Kreyl/LocketSound/SndLocket_hw/Pdf/SndLocket.pdf

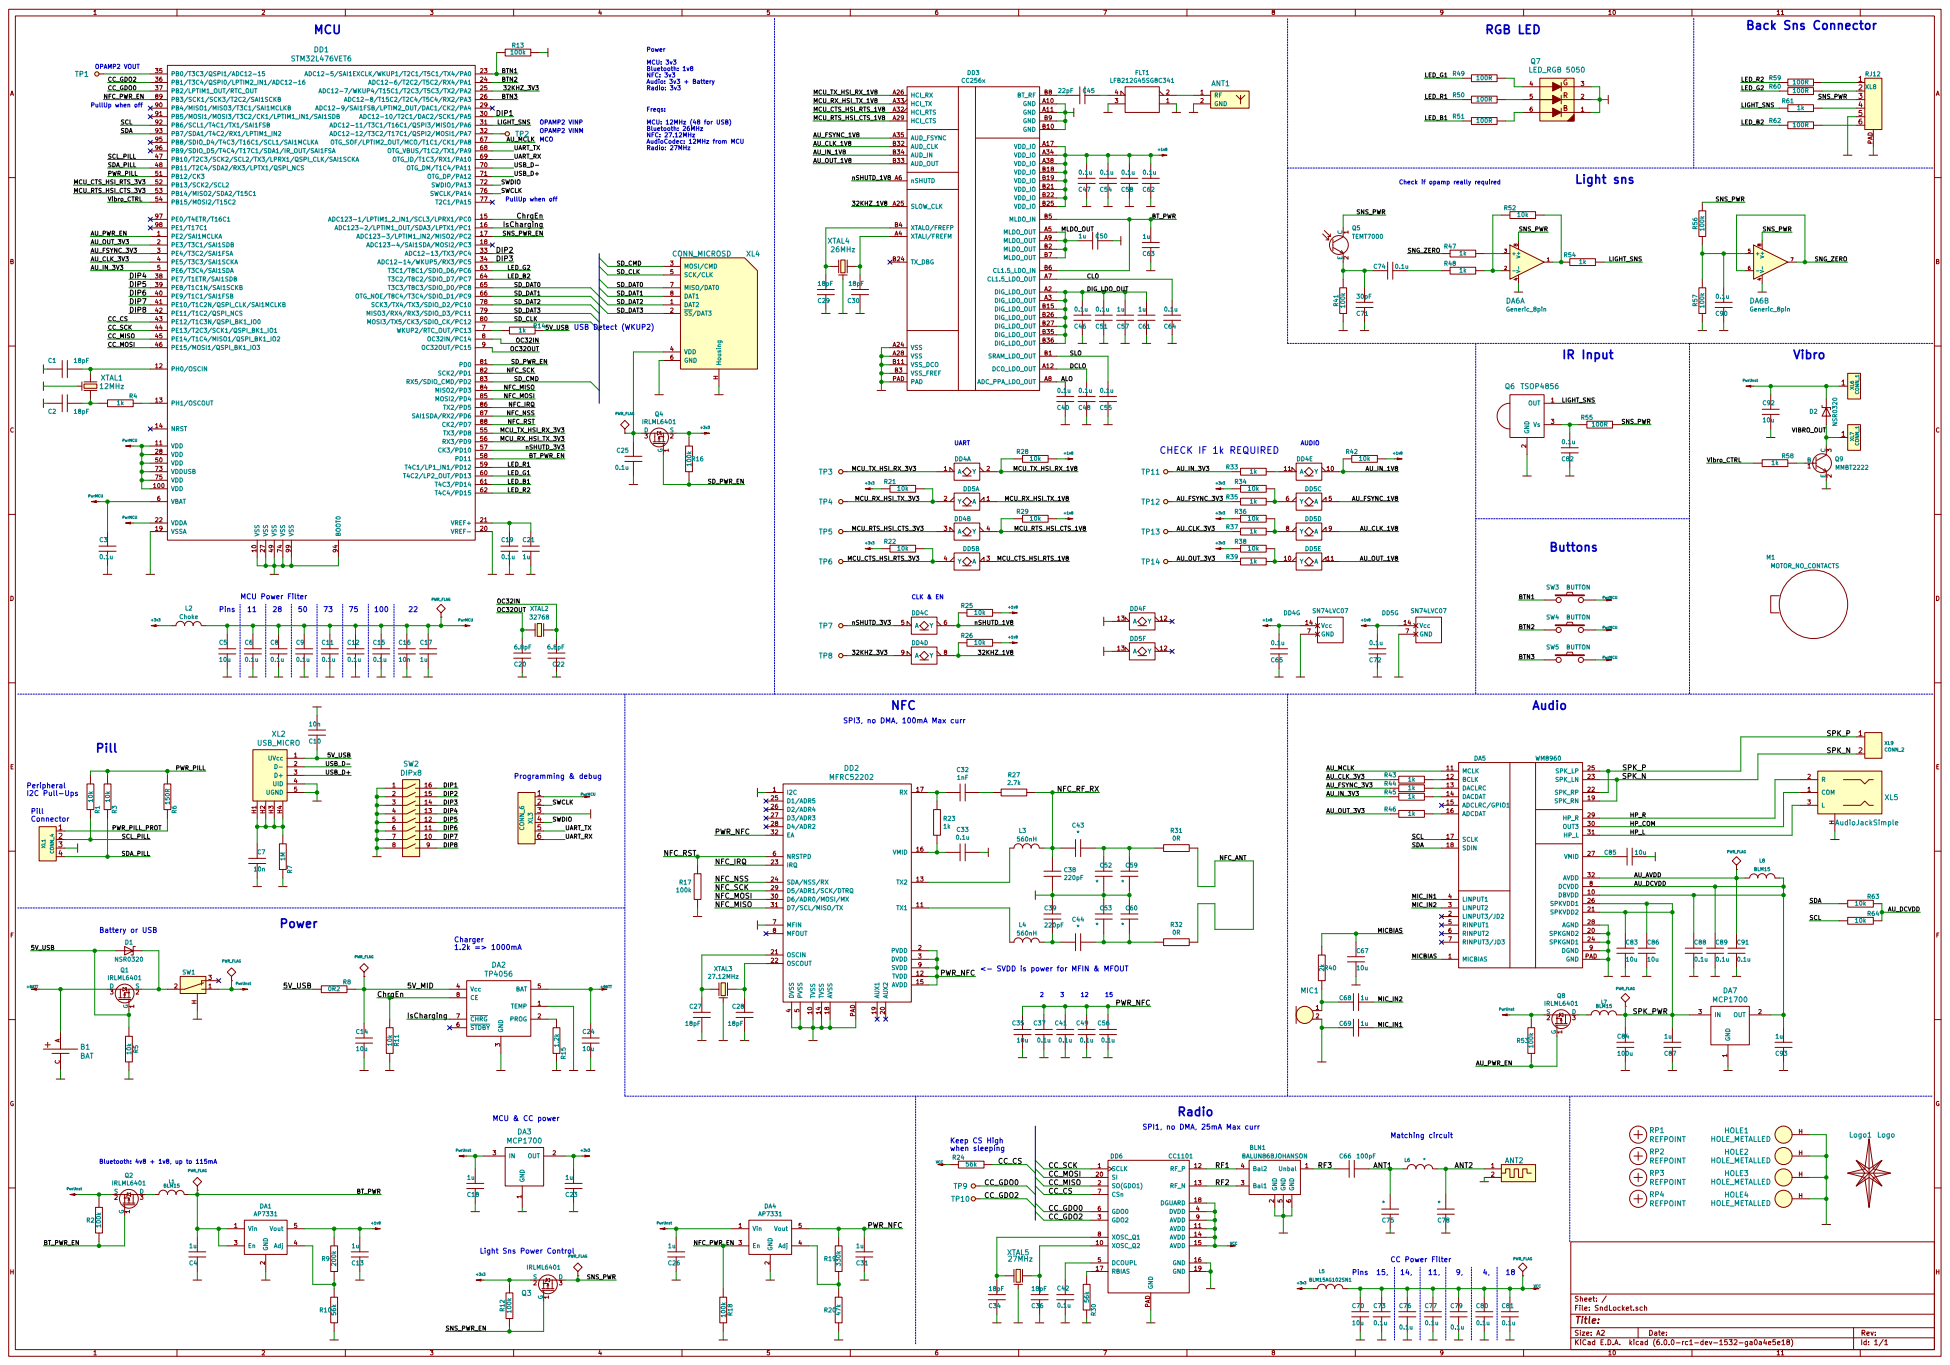
[picture p1: page 1]

+1v8 Freqs:
MCU: 12MHz (48 for USB) Bluetooth: 26MHz NFC: 27.12MHz AudioCodec: 12MHz from MCU

Audio | 10u AU_MCLK 10 MCLK

SPI3, no DMA, 100mA Max curr

5 NRSTPD 6 MFIN 7 MFOUT 8 SVDD 9 PAD DD2 MFRC52202

23 SPKGND1 21 SPK_RP

4 | 13
5 | 12
6 | 11
7 | 10

PwrUnst Battery or USB
D1 NSR0320

3 Vcc 4 BAT 5 STDBY 6 CHRG 7 CE 8 DA2 TP4056 R15 1.2k

<- SVDD is power for MFIN & MFOUT

SPI1, no DMA, 25mA Max curr

Light Sns Power Control

Id: 1/1 Title: File: SndLocket.sch Sheet: /
