Kreyl/LocketSound/SndLocket_hw/SndLocket.kicad_pcb

## KiCad design SndLocket_hw/SndLocket.kicad_pcb (2022-02-10)

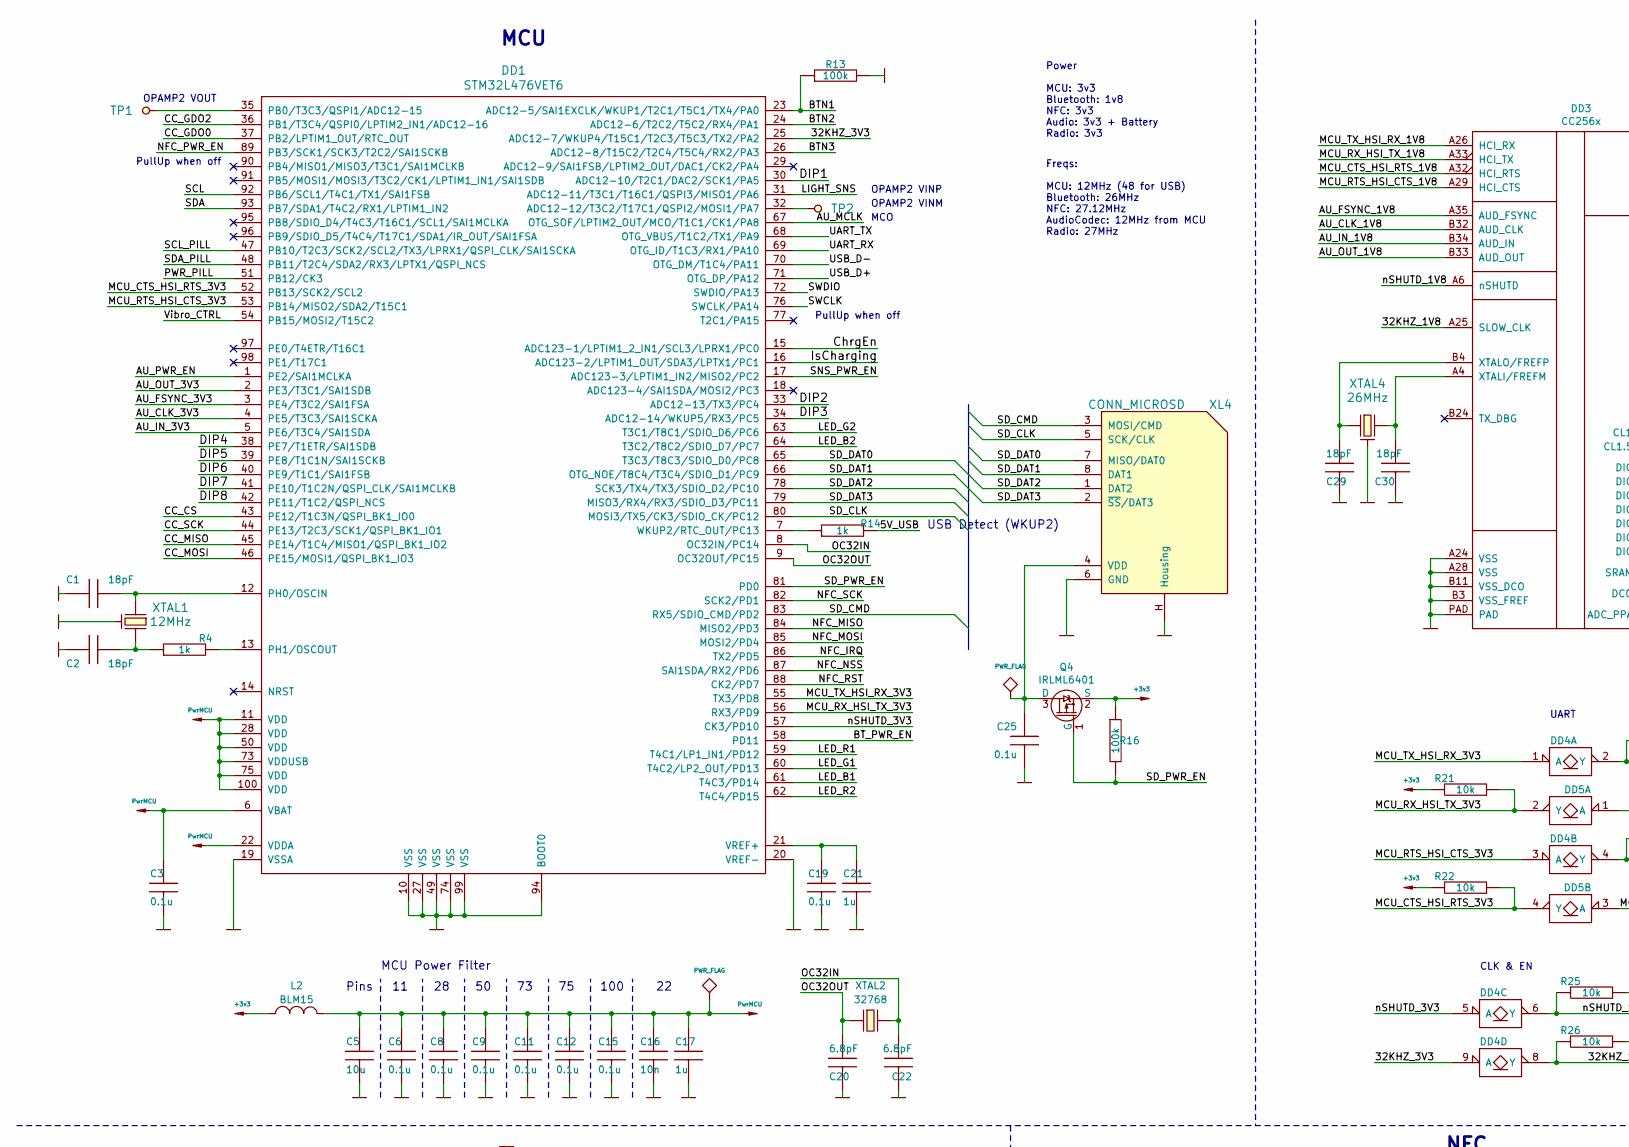
[picture p2: schematic SndLocket.sch, part in row 1, column 1]

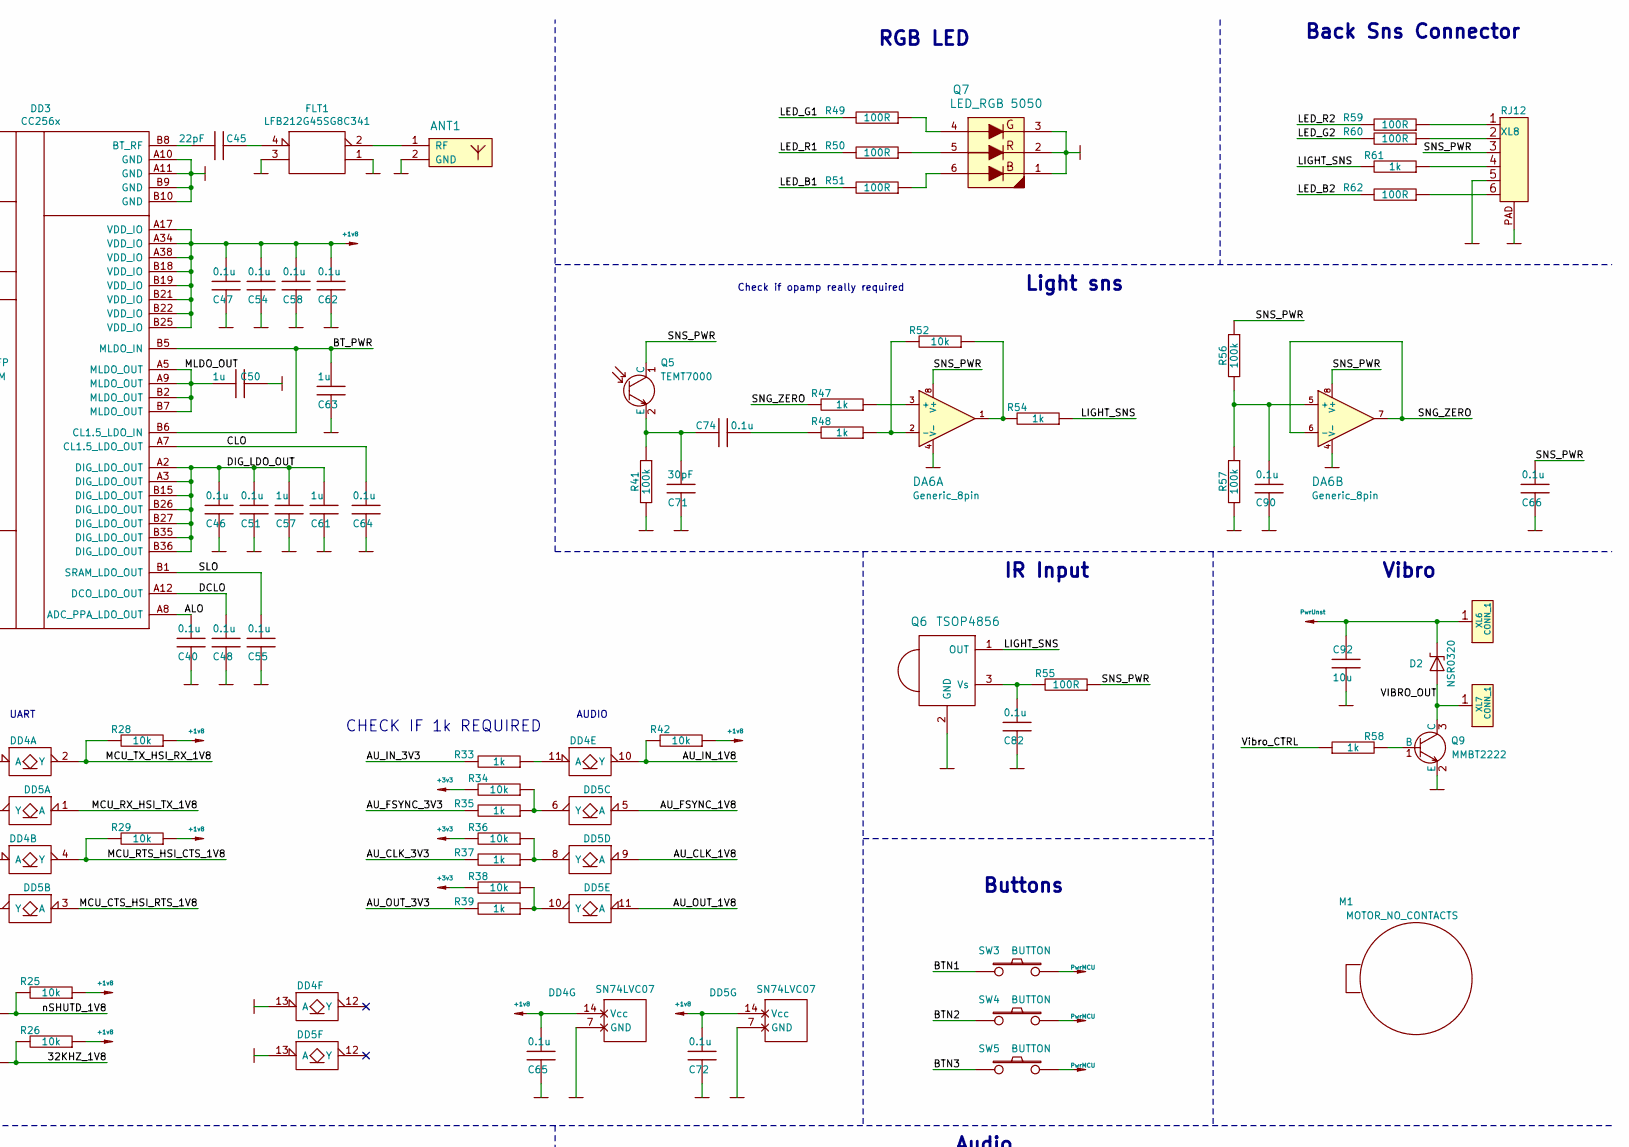
[picture p3: schematic SndLocket.sch, part in row 1, column 2]

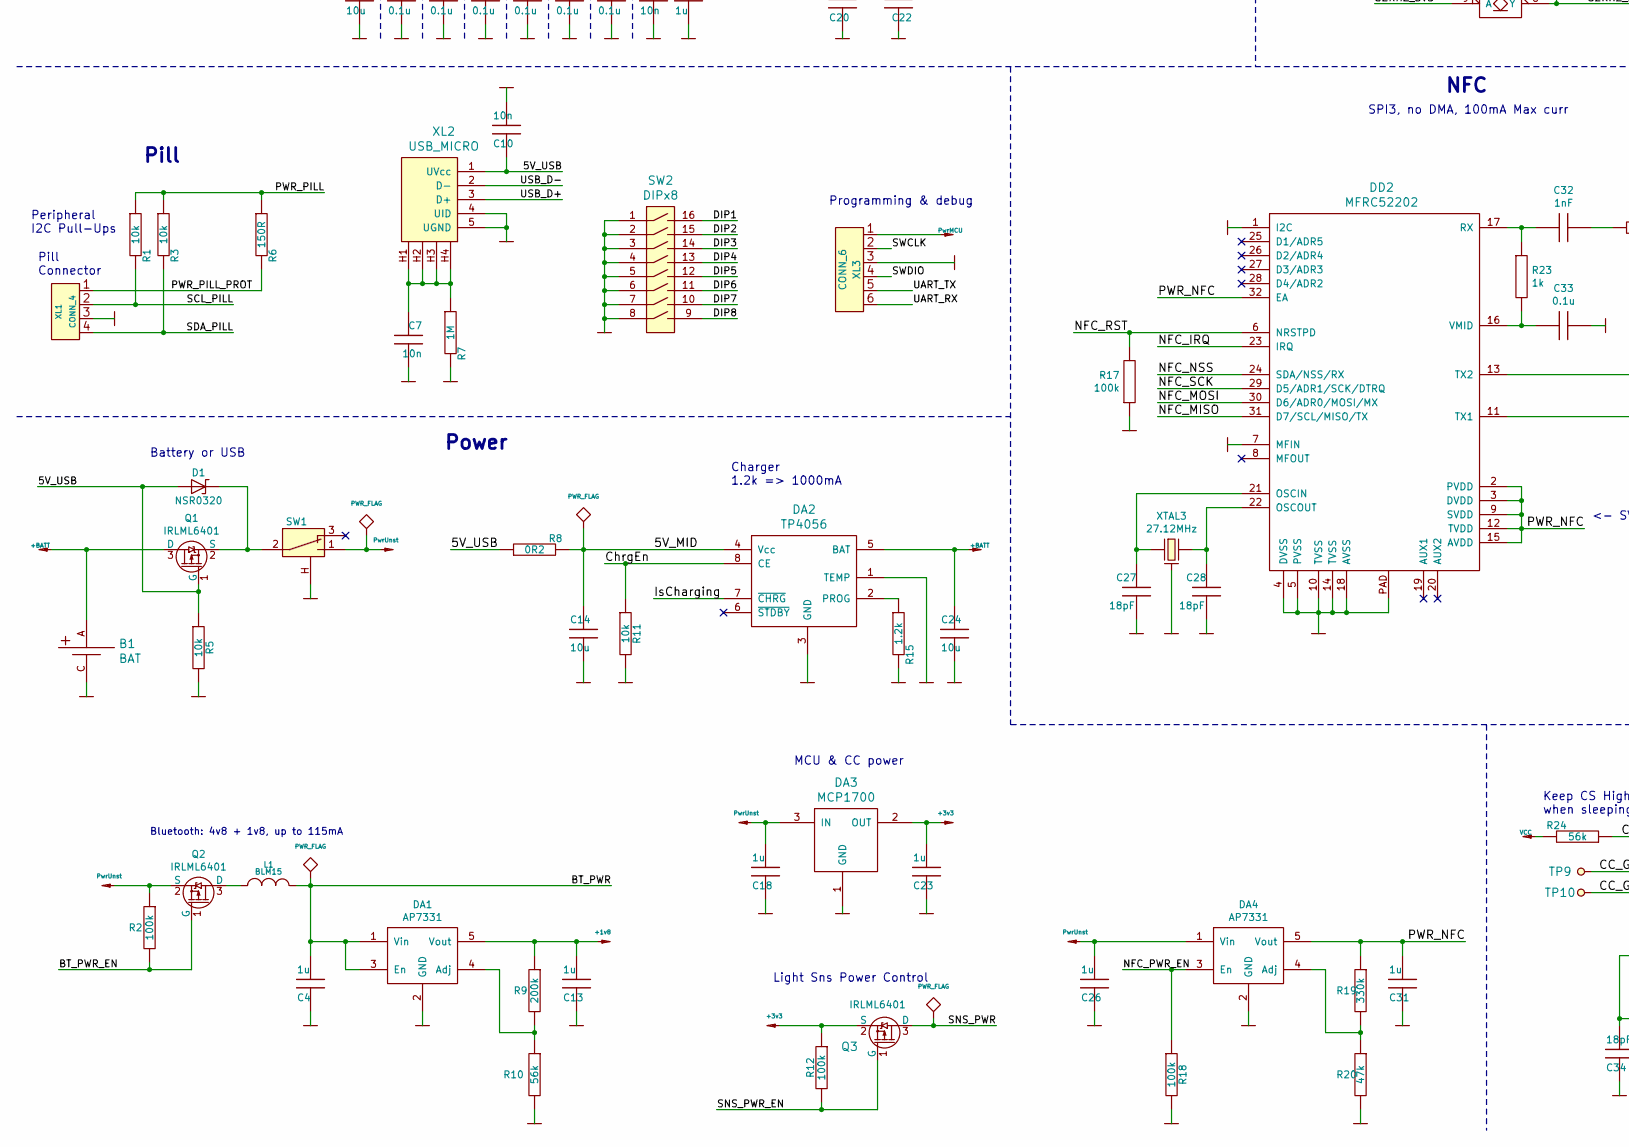
[picture p4: schematic SndLocket.sch, part in row 2, column 1]

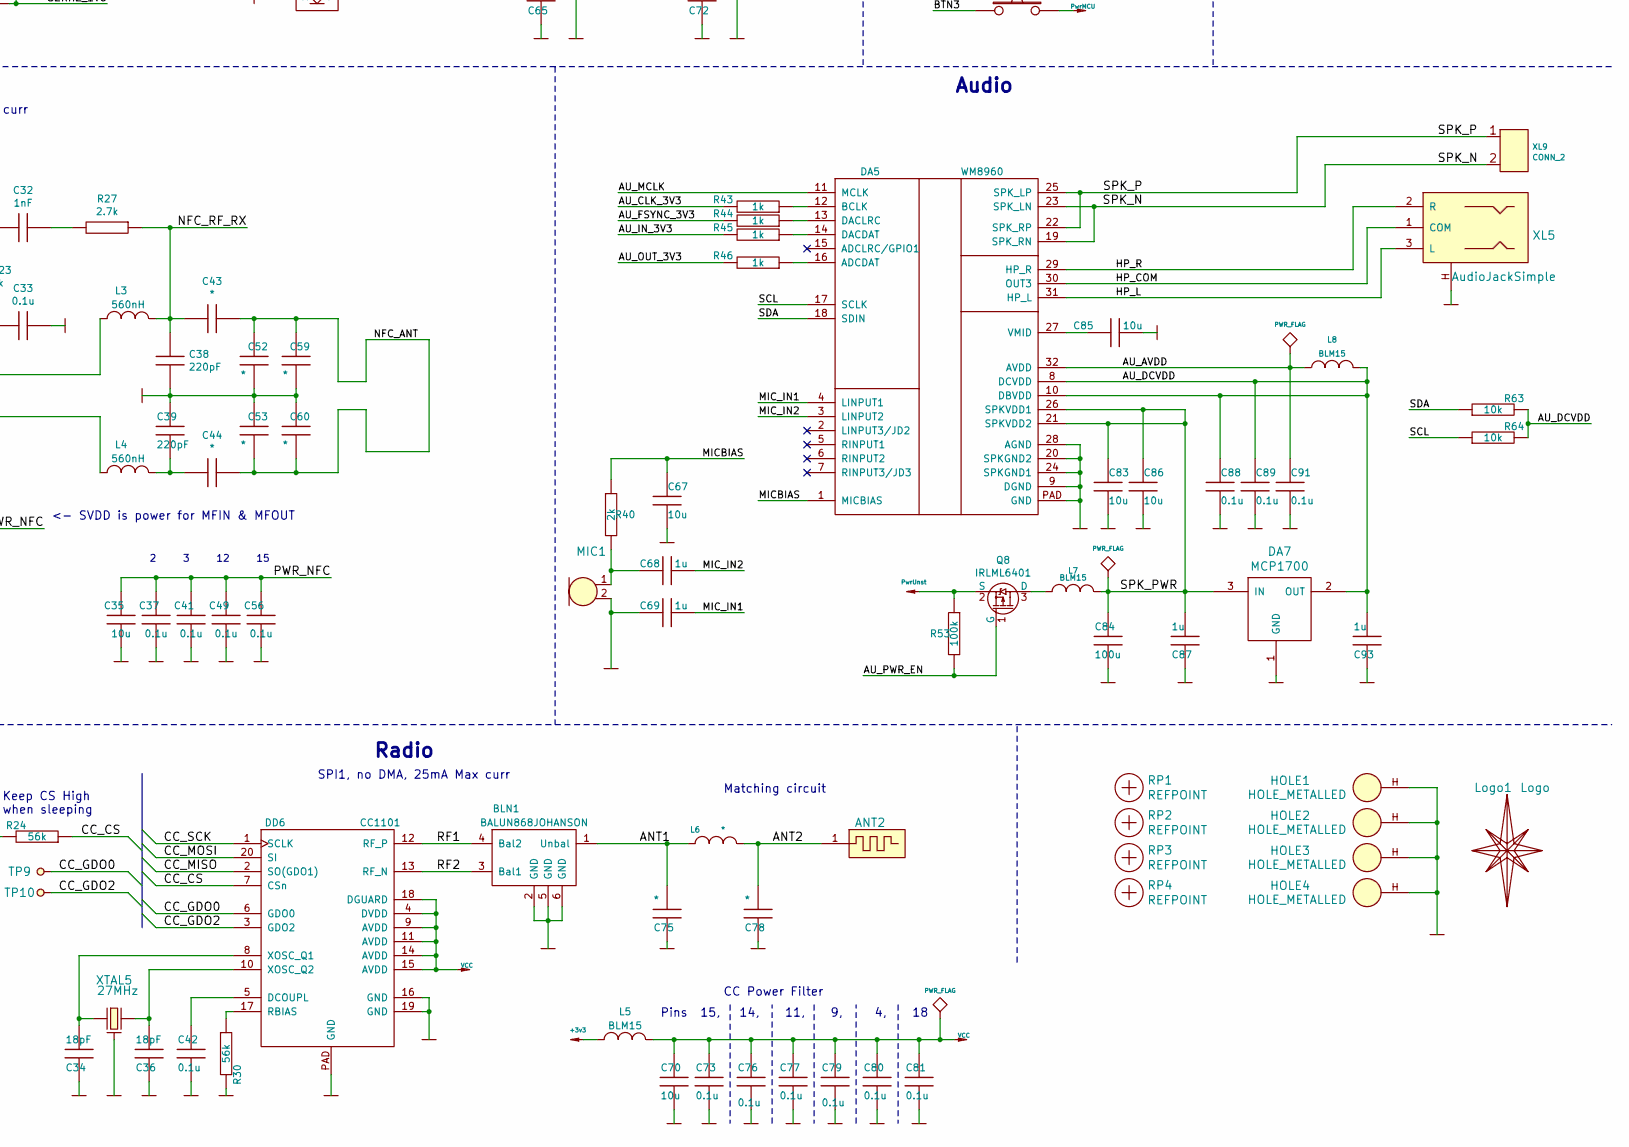
[picture p5: schematic SndLocket.sch, part in row 2, column 2]

Parts:
ANT1: ANT_GENERAL; LcktSnd_2d41
ANT2: ANT_PCB_MONO_2PIN; LcktSnd_868
B1: BAT; 18650x1
BLN1: BALUN868JOHANSON; BALUN_JOHANSON868
C1, C2, C27, C28, C29, C30, C34, C36: 18pF; CAP_0603
C3, C6, C8, C9, C11, C12, C15, C19, C25, C33, C37, C40, C41, C42, C46, C47, C48, C49, C51, C54, C55, C56, C58, C62, C64, C65, C66, C72, C73, C74, C76, C77, C79, C80, C81, C82, C88, C89, C90, C91: 0.1u; CAP_0402
C4, C13, C17, C18, C21, C23, C26, C31, C50, C57, C61, C63, C68, C69, C87, C93: 1u; CAP_0603
C5, C14, C24, C35, C67, C70, C83, C85, C86, C92: 10u; CAP_0603
C7, C10, C16: 10n; CAP_0603
C20, C22: 6.8pF; CAP_0603
C32: 1nF; CAP_0603
C38, C39: 220pF; CAP_0603
C43, C44, C52, C53, C59, C60: *; CAP_0603
C45: 22pF; CAP_0402
C71: 30pF; CAP_0603
C75, C78: *; CAP_0402
C84: 100u; CAP_1206
D1, D2: NSR0320; SOD323
DA1, DA4: AP7331; SOT23-5
DA2: TP4056; SO8_150MIL
DA3, DA7: MCP1700; SOT23-3A
DA5: WM8960; QFN32_EP_5x5_Pitch0.5mm
DA6: Generic_8pin; SO8_150MIL
DD1: STM32L476VET6; LQFP100
DD2: MFRC52202; QFN32_EP_5x5_Pitch0.5mm
DD3: CC256x; mrQFN76
DD4, DD5: SN74LVC07; SO14
DD6: CC1101; QFN20
FLT1: LFB212G45SG8C341; FLT_LFB21
HOLE1, HOLE2, HOLE3, HOLE4: HOLE_METALLED; Hole2d2_out3d5mm
L1, L2, L5, L7, L8: BLM15; IND_0402
L3, L4: 560nH; IND_0805
L6: *; IND_0402
Logo1: Logo; Ostranna_12d7_10d1
M1: MOTOR_NO_CONTACTS; Motor_no_Contacts
MIC1: Microphone; PLS-2
Q1, Q2, Q3, Q4, Q8: IRLML6401; SOT23-3
Q5: TEMT7000; RES_1206
Q6: TSOP4856; TSOP48xx
Q7: LED_RGB 5050; LED_5050
Q9: MMBT2222; SOT23-3
R1, R3, R5, R11, R21, R22, R25, R26, R28, R29, R34, R36, R38, R42, R52, R63, R64: 10k; RES_0603
R2, R12, R13, R16, R17, R18, R41, R53, R56, R57: 100k; RES_0603
R4, R14, R23, R33, R35, R37, R39, R43, R44, R45, R46, R47, R48, R54, R58, R61: 1k; RES_0603
R6: 150R; RES_0603
R7: 1M; RES_0603
R8: 0R2; RES_1206
R9: 200k; RES_0603
R10, R24, R30: 56k; RES_0603
R15: 1.2k; RES_0603
R19: 330k; RES_0603
R20: 47k; RES_0603
R27: 2.7k; RES_0603
R40: 2k; RES_0603
R49, R50, R51, R55, R59, R60, R62: 100R; RES_0603
RP1, RP2, RP3, RP4: REFPOINT; REF_POINT_1MM
SW1: SWITCH; SW_SS-1P2T_Housing
SW2: DIPx8; DIP_SMD_X8
SW3, SW4, SW5: BUTTON; BTN_IT1198
TP1, TP2, TP9, TP10: TESTPOINT; TESTPOINT_1MM
XL1: CONN_4; PBS-4R
XL2: USB_MICRO; USBmicro_MOLEX_1050170001
XL3: CONN_6; PLS-6
XL4: CONN_MICROSD; MICROSD_EJECTOR_TFWF1
XL5: AudioJackSimple; AUDIO_CKX3_5_30
XL6, XL7: CONN_1; Oval3x1.5
XL8: RJ12; RJ11_TJ6_6P6C
XL9: CONN_2; SLD_2_2D5
XTAL1: 12MHz; 03225C4
XTAL2: 32768; 03215C2
XTAL3: 27.12MHz; 03225C4
XTAL4: 26MHz; 03225C4
XTAL5: 27MHz; 03225C4

Connections:
+1v8: C13.1, C47.1, C54.1, C58.1, C62.1, C65.1, C72.1, DA1.5 (Vout), DD3.A17 (VDD_IO), DD3.A34 (VDD_IO), DD3.A38 (VDD_IO), DD3.B18 (VDD_IO), DD3.B19 (VDD_IO), DD3.B21 (VDD_IO), DD3.B22 (VDD_IO), DD3.B25 (VDD_IO), DD4.14 (Vcc), DD5.14 (Vcc), R9.1, R25.1, R26.1, R28.1, R29.1, R42.1
+3v3: C23.1, DA3.2 (OUT), L2.2, L5.2, Q3.2 (S), Q4.2 (S), R12.1, R16.1, R21.2, R22.2, R34.2, R36.2, R38.2
+BATT: B1.A, C24.2, DA2.5 (BAT), Q1.3 (D)
/5V_MID: C14.2, DA2.4 (Vcc), R8.2
/5V_USB: C10.2, D1.A, Q1.1 (G), R5.1, R8.1, R14.2, XL2.1 (UVcc)
/32KHZ_1V8: DD3.A25 (SLOW_CLK), DD4.8 (Y), R26.2
/32KHZ_3V3: DD1.25 (ADC12-7/WKUP4/T15C1/T2C3/T5C3/TX2/PA2), DD4.9 (A)
/ALO: C40.1, DD3.A8 (ADC_PPA_LDO_OUT)
/ANT1: BLN1.1 (Unbal), C75.1, L6.2
/ANT2: ANT2.1, C78.1, L6.1
/AU_AVDD: C91.1, DA5.32 (AVDD), L8.1
/AU_CLK_1V8: DD3.B32 (AUD_CLK), DD5.9 (A)
/AU_CLK_3V3: DD1.4 (PE5/T3C3/SAI1SCKA), R37.2, R43.2
/AU_DCVDD: C88.1, C89.1, C93.1, DA5.8 (DCVDD), DA5.10 (DBVDD), DA7.2 (OUT), L8.2, R63.2, R64.2
/AU_FSYNC_1V8: DD3.A35 (AUD_FSYNC), DD5.5 (A)
/AU_FSYNC_3V3: DD1.3 (PE4/T3C2/SAI1FSA), R35.2, R44.2
/AU_IN_1V8: DD3.B34 (AUD_IN), DD4.10 (Y), R42.2
/AU_IN_3V3: DD1.5 (PE6/T3C4/SAI1SDA), R33.2, R45.2
/AU_MCLK: DA5.11 (MCLK), DD1.67 (OTG_SOF/LPTIM2_OUT/MCO/T1C1/CK1/PA8)
/AU_OUT_1V8: DD3.B33 (AUD_OUT), DD5.11 (A)
/AU_OUT_3V3: DD1.2 (PE3/T3C1/SAI1SDB), R39.2, R46.2
/AU_PWR_EN: DD1.1 (PE2/SAI1MCLKA), Q8.1 (G), R53.2
/BTN1: DD1.23 (ADC12-5/SAI1EXCLK/WKUP1/T2C1/T5C1/TX4/P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), R13.1, SW3.1
/BTN2: DD1.24 (ADC12-6/T2C2/T5C2/RX4/PA1), SW4.1
/BTN3: DD1.26 (ADC12-8/T15C2/T2C4/T5C4/RX2/PA3), SW5.1
/BT_PWR: C4.1, C63.1, DA1.1 (Vin), DA1.3 (En), DD3.B5 (MLDO_IN), DD3.B6 (CL1.5_LDO_IN), L1.1
/BT_PWR_EN: DD1.58 (PD11), Q2.1 (G), R2.2
/CC_CS: DD1.43 (PE12/T1C3N/QSPI_BK1_IO0), DD6.7 (CSn), R24.1
/CC_GDO0: DD1.37 (PB2/LPTIM1_OUT/RTC_OUT), DD6.6 (GDO0), TP9.1
/CC_GDO2: DD1.36 (PB1/T3C4/QSPI0/LPTIM2_IN1/ADC12-16), DD6.3 (GDO2), TP10.1
/CC_MISO: DD1.45 (PE14/T1C4/MISO1/QSPI_BK1_IO2), DD6.2 (SO(GDO1))
/CC_MOSI: DD1.46 (PE15/MOSI1/QSPI_BK1_IO3), DD6.20 (SI)
/CC_SCK: DD1.44 (PE13/T2C3/SCK1/QSPI_BK1_IO1), DD6.1 (SCLK)
/CLO: C64.1, DD3.A7 (CL1.5_LDO_OUT)
/ChrgEn: DA2.8 (CE), DD1.15 (ADC123-1/LPTIM1_2_IN1/SCL3/LPRX1/PC0), R11.1
/DCLO: C48.1, DD3.A12 (DCO_LDO_OUT)
/DIG_LDO_OUT: C46.1, C51.1, C57.1, C61.1, DD3.A2 (DIG_LDO_OUT), DD3.A3 (DIG_LDO_OUT), DD3.B15 (DIG_LDO_OUT), DD3.B26 (DIG_LDO_OUT), DD3.B27 (DIG_LDO_OUT), DD3.B35 (DIG_LDO_OUT), DD3.B36 (DIG_LDO_OUT)
/DIP1: DD1.30 (ADC12-10/T2C1/DAC2/SCK1/PA5), SW2.16
/DIP2: DD1.33 (ADC12-13/TX3/PC4), SW2.15
/DIP3: DD1.34 (ADC12-14/WKUP5/RX3/PC5), SW2.14
/DIP4: DD1.38 (PE7/T1ETR/SAI1SDB), SW2.13
/DIP5: DD1.39 (PE8/T1C1N/SAI1SCKB), SW2.12
/DIP6: DD1.40 (PE9/T1C1/SAI1FSB), SW2.11
/DIP7: DD1.41 (PE10/T1C2N/QSPI_CLK/SAI1MCLKB), SW2.10
/DIP8: DD1.42 (PE11/T1C2/QSPI_NCS), SW2.9
/HP_COM: DA5.30 (OUT3), XL5.1 (COM)
/HP_L: DA5.31 (HP_L), XL5.3 (L)
/HP_R: DA5.29 (HP_R), XL5.2 (R)
/IsCharging: DA2.7 (~CHRG), DD1.16 (ADC123-2/LPTIM1_OUT/SDA3/LPTX1/PC1)
/LED_B1: DD1.61 (T4C3/PD14), R51.2
/LED_B2: DD1.64 (T3C2/T8C2/SDIO_D7/PC7), R62.2
/LED_G1: DD1.60 (T4C2/LP2_OUT/PD13), R49.2
/LED_G2: DD1.63 (T3C1/T8C1/SDIO_D6/PC6), R60.2
/LED_R1: DD1.59 (T4C1/LP1_IN1/PD12), R50.2
/LED_R2: DD1.62 (T4C4/PD15), R59.2
/LIGHT_SNS: DD1.31 (ADC12-11/T3C1/T16C1/QSPI3/MISO1/PA6), Q6.1 (OUT), R54.1, R61.2
/MCU_CTS_HSI_RTS_1V8: DD3.A32 (HCI_RTS), DD5.3 (A)
/MCU_CTS_HSI_RTS_3V3: DD1.52 (PB13/SCK2/SCL2), DD5.4 (Y), R22.1
/MCU_RTS_HSI_CTS_1V8: DD3.A29 (HCI_CTS), DD4.4 (Y), R29.2
/MCU_RTS_HSI_CTS_3V3: DD1.53 (PB14/MISO2/SDA2/T15C1), DD4.3 (A)
/MCU_RX_HSI_TX_1V8: DD3.A33 (HCI_TX), DD5.1 (A)
/MCU_RX_HSI_TX_3V3: DD1.56 (RX3/PD9), DD5.2 (Y), R21.1
/MCU_TX_HSI_RX_1V8: DD3.A26 (HCI_RX), DD4.2 (Y), R28.2
/MCU_TX_HSI_RX_3V3: DD1.55 (TX3/PD8), DD4.1 (A)
/MICBIAS: C67.1, DA5.1 (MICBIAS), R40.1
/MIC_IN1: C69.1, DA5.4 (LINPUT1)
/MIC_IN2: C68.1, DA5.3 (LINPUT2)
/MLDO_OUT: C50.1, DD3.A5 (MLDO_OUT), DD3.A9 (MLDO_OUT), DD3.B2 (MLDO_OUT), DD3.B7 (MLDO_OUT)
/NFC_ANT: C43.1, C44.1, C52.1, C53.2, C59.1, C60.2
/NFC_IRQ: DD1.86 (TX2/PD5), DD2.23 (IRQ)
/NFC_MISO: DD1.84 (MISO2/PD3), DD2.31 (D7/SCL/MISO/TX)
/NFC_MOSI: DD1.85 (MOSI2/PD4), DD2.30 (D6/ADR0/MOSI/MX)
/NFC_NSS: DD1.87 (SAI1SDA/RX2/PD6), DD2.24 (SDA/NSS/RX)
/NFC_PWR_EN: DA4.3 (En), DD1.89 (PB3/SCK1/SCK3/T2C2/SAI1SCKB), R18.1
/NFC_RF_RX: C38.1, C43.2, L3.1, R27.1
/NFC_RST: DD1.88 (CK2/PD7), DD2.6 (NRSTPD), R17.2
/NFC_SCK: DD1.82 (SCK2/PD1), DD2.29 (D5/ADR1/SCK/DTRQ)
/OC32IN: C22.1, DD1.8 (OC32IN/PC14), XTAL2.2
/OC32OUT: C20.1, DD1.9 (OC32OUT/PC15), XTAL2.1
/PWR_NFC: C31.1, C35.2, C37.2, C41.2, C49.2, C56.2, DA4.5 (Vout), DD2.2 (PVDD), DD2.3 (DVDD), DD2.9 (SVDD), DD2.12 (TVDD), DD2.15 (AVDD), DD2.32 (EA), R19.1
/PWR_PILL: DD1.51 (PB12/CK3), R1.1, R3.1, R6.1
/PWR_PILL_PROT: R6.2, XL1.1
/RF1: BLN1.4 (Bal2), DD6.12 (RF_P)
/RF2: BLN1.3 (Bal1), DD6.13 (RF_N)
/SCL: DA5.17 (SCLK), DD1.92 (PB6/SCL1/T4C1/TX1/SAI1FSB), R64.1
/SCL_PILL: DD1.47 (PB10/T2C3/SCK2/SCL2/TX3/LPRX1/QSPI_CLK/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), R1.2, XL1.2 (PM)
/SDA: DA5.18 (SDIN), DD1.93 (PB7/SDA1/T4C2/RX1/LPTIM1_IN2), R63.1
/SDA_PILL: DD1.48 (PB11/T2C4/SDA2/RX3/LPTX1/QSPI_NCS), R3.2, XL1.4
/SD_CLK: DD1.80 (MOSI3/TX5/CK3/SDIO_CK/PC12), XL4.5 (SCK/CLK)
/SD_CMD: DD1.83 (RX5/SDIO_CMD/PD2), XL4.3 (MOSI/CMD)
/SD_DAT0: DD1.65 (T3C3/T8C3/SDIO_D0/PC8), XL4.7 (MISO/DAT0)
/SD_DAT1: DD1.66 (OTG_NOE/T8C4/T3C4/SDIO_D1/PC9), XL4.8 (DAT1)
/SD_DAT2: DD1.78 (SCK3/TX4/TX3/SDIO_D2/PC10), XL4.1 (DAT2)
/SD_DAT3: DD1.79 (MISO3/RX4/RX3/SDIO_D3/PC11), XL4.2 (~SS~/DAT3)
/SD_PWR_EN: DD1.81 (PD0), Q4.1 (G), R16.2
/SLO: C55.1, DD3.B1 (SRAM_LDO_OUT)
/SNG_ZERO: DA6.6 (-), DA6.7, R47.2
/SNS_PWR: C66.1, DA6.8 (V+), Q3.3 (D), Q5.1 (C), R55.1, R56.1, XL8.3
/SNS_PWR_EN: DD1.17 (ADC123-3/LPTIM1_IN2/MISO2/PC2), Q3.1 (G), R12.2
/SPK_N: DA5.19 (SPK_RN), DA5.23 (SPK_LN), XL9.2 (PM)
/SPK_P: DA5.22 (SPK_RP), DA5.25 (SPK_LP), XL9.1
/SPK_PWR: C83.1, C84.1, C86.1, C87.1, DA5.21 (SPKVDD2), DA5.26 (SPKVDD1), DA7.3 (IN), L7.1
/SWCLK: DD1.76 (SWCLK/PA14), XL3.2
/SWDIO: DD1.72 (SWDIO/PA13), XL3.4
/UART_RX: DD1.69 (OTG_ID/T1C3/RX1/PA10), XL3.6
/UART_TX: DD1.68 (OTG_VBUS/T1C2/TX1/PA9), XL3.5
/USB_D+: DD1.71 (OTG_DP/PA12), XL2.3 (D+)
/USB_D-: DD1.70 (OTG_DM/T1C4/PA11), XL2.2 (D-)
/VIBRO_OUT: D2.A, Q9.3 (C), XL7.1
/Vibro_CTRL: DD1.54 (PB15/MOSI2/T15C2), R58.1
/nSHUTD_1V8: DD3.A6 (nSHUTD), DD4.6 (Y), R25.2
/nSHUTD_3V3: DD1.57 (CK3/PD10), DD4.5 (A)
GND: ANT1.2 (GND), B1.C, BLN1.2 (GND), BLN1.5 (GND), BLN1.6 (GND), C1.2, C2.2, C3.1, C4.2, C5.1, C6.1, C7.1, C8.1, C9.1, C10.1, C11.1, C12.1, C13.2, C14.1, C15.1, C16.1, C17.1, C18.2, C19.1, C20.2, C21.1, C22.2, C23.2, C24.1, C25.2, C26.2, C27.2, C28.2, C29.2, C30.2, C31.2, C33.1, C34.2, C35.1, C36.2, C37.1, C38.2, C39.1, C40.2, C41.1, C42.1, C46.2, C47.2, C48.2, C49.1, C50.2, C51.2, C52.2, C53.1, C54.2, C55.2, C56.1, C57.2, C58.2, C59.2, C60.1, C61.2, C62.2, C63.2, C64.2, C65.2, C66.2, C67.2, C69.2, C70.2, C71.2, C72.2, C73.2, C75.2, C76.2, C77.2, C78.2, C79.2, C80.2, C81.2, C82.2, C83.2, C84.2, C85.2, C86.2, C87.2, C88.2, C89.2, C90.2, C91.2, C92.1, C93.2, DA1.2 (GND), DA2.1 (TEMP), DA2.3 (GND), DA3.1 (GND), DA4.2 (GND), DA5.9 (DGND), DA5.20 (SPKGND2), DA5.24 (SPKGND1), DA5.28 (AGND), DA5.PAD (GND), DA6.4 (V-), DA7.1 (GND), DD1.10 (VSS), DD1.19 (VSSA), DD1.20 (VREF-), DD1.27 (VSS), DD1.49 (VSS), DD1.74 (VSS), DD1.94 (BOOT0), DD1.99 (VSS), DD2.1 (I2C), DD2.4 (DVSS), DD2.5 (PVSS), DD2.7 (MFIN), DD2.10 (TVSS), DD2.14 (TVSS), DD2.18 (AVSS), DD2.PAD, DD3.A10 (GND), DD3.A11 (GND), DD3.A24 (VSS), DD3.A28 (VSS), DD3.B3 (VSS_FREF), DD3.B9 (GND), DD3.B10 (GND), DD3.B11 (VSS_DCO), DD3.PAD, DD4.7 (GND), DD4.13 (A), DD5.7 (GND), DD5.13 (A), DD6.16 (GND), DD6.19 (GND), DD6.PAD (GND), FLT1.1, FLT1.3, HOLE1.H, HOLE2.H, HOLE3.H, HOLE4.H, MIC1.2, Q6.2 (GND), Q7.1, Q7.2, Q7.3, Q9.2 (E), R5.2, R7.2, R10.2, R11.2, R13.2, R15.2, R17.1, R18.2, R20.2, R30.2, R41.2, R57.2, SW1.H, SW2.1, SW2.2, SW2.3, SW2.4, SW2.5, SW2.6, SW2.7, SW2.8, XL1.3, XL2.4 (UID), XL2.5 (UGND), XL3.3, XL4.6 (GND), XL4.H (Housing), XL5.H, XL8.5, XL8.PAD, XTAL1.H, XTAL3.H, XTAL4.H, XTAL5.H
unnamed: ANT1.1 (RF), FLT1.2
unnamed: C1.1, DD1.12 (PH0/OSCIN), XTAL1.1
unnamed: C2.1, R4.1, XTAL1.2
unnamed: C7.2, R7.1, XL2.H1, XL2.H2, XL2.H3, XL2.H4
unnamed: C19.2, C21.2, DD1.21 (VREF+)
unnamed: C25.1, Q4.3 (D), XL4.4 (VDD)
unnamed: C27.1, DD2.21 (OSCIN), XTAL3.1
unnamed: C28.1, DD2.22 (OSCOUT), XTAL3.2
unnamed: C29.1, DD3.B4 (XTALO/FREFP), XTAL4.1
unnamed: C30.1, DD3.A4 (XTALI/FREFM), XTAL4.2
unnamed: C32.1, R27.2
unnamed: C32.2, DD2.17 (RX), R23.1
unnamed: C33.2, DD2.16 (VMID), R23.2
unnamed: C34.1, DD6.8 (XOSC_Q1), XTAL5.1
unnamed: C36.1, DD6.10 (XOSC_Q2), XTAL5.2
unnamed: C39.2, C44.2, L4.1
unnamed: C42.2, DD6.5 (DCOUPL)
unnamed: C45.1, DD3.B8 (BT_RF)
unnamed: C45.2, FLT1.4
unnamed: C68.2, MIC1.1, R40.2
unnamed: C71.1, C74.2, Q5.2 (E), R41.1
unnamed: C74.1, R48.2
unnamed: C82.1, Q6.3 (Vs), R55.2
unnamed: C85.1, DA5.27 (VMID)
unnamed: C90.1, DA6.5 (+), R56.2, R57.1
unnamed: D1.C, Q1.2 (S), SW1.2
unnamed: DA1.4 (Adj), R9.2, R10.1
unnamed: DA2.2 (PROG), R15.1
unnamed: DA4.4 (Adj), R19.2, R20.1
unnamed: DA5.12 (BCLK), R43.1
unnamed: DA5.13 (DACLRC), R44.1
unnamed: DA5.14 (DACDAT), R45.1
unnamed: DA5.16 (ADCDAT), R46.1
unnamed: DA6.1, R52.1, R54.2
unnamed: DA6.2 (-), R48.1, R52.2
unnamed: DA6.3 (+), R47.1
unnamed: DD1.7 (WKUP2/RTC_OUT/PC13), R14.1
unnamed: DD1.13 (PH1/OSCOUT), R4.2
unnamed: DD1.32 (ADC12-12/T3C2/T17C1/QSPI2/MOSI1/PA7), TP2.1
unnamed: DD1.35 (PB0/T3C3/QSPI1/ADC12-15), TP1.1
unnamed: DD2.11 (TX1), L4.2
unnamed: DD2.13 (TX2), L3.2
unnamed: DD4.11 (A), R33.1
unnamed: DD5.6 (Y), R34.1, R35.1
unnamed: DD5.8 (Y), R36.1, R37.1
unnamed: DD5.10 (Y), R38.1, R39.1
unnamed: DD6.17 (RBIAS), R30.1
unnamed: L1.2, Q2.3 (D)
unnamed: L7.2, Q8.3 (D)
unnamed: Q7.4 (B), R49.1
unnamed: Q7.5 (G), R50.1
unnamed: Q7.6, R51.1
unnamed: Q9.1 (B), R58.2
unnamed: R59.1, XL8.1
unnamed: R60.1, XL8.2
unnamed: R61.1, XL8.4
unnamed: R62.1, XL8.6
PwrMCU: C3.2, C5.2, C6.2, C8.2, C9.2, C11.2, C12.2, C15.2, C16.2, C17.2, DD1.6 (VBAT), DD1.11 (VDD), DD1.22 (VDDA), DD1.28 (VDD), DD1.50 (VDD), DD1.73 (VDDUSB), DD1.75 (VDD), DD1.100 (VDD), L2.1, SW3.2, SW4.2, SW5.2, XL3.1
PwrUnst: C18.1, C26.1, C92.2, D2.C, DA3.3 (IN), DA4.1 (Vin), Q2.2 (S), Q8.2 (S), R2.1, R53.1, SW1.1, XL6.1
VCC: C70.1, C73.1, C76.1, C77.1, C79.1, C80.1, C81.1, DD6.4 (DVDD), DD6.9 (AVDD), DD6.11 (AVDD), DD6.14 (AVDD), DD6.15 (AVDD), DD6.18 (DGUARD), L5.1, R24.2

Notes on the sheet:
Audio
MCU & CC power
Power
Charger 1.2k => 1000mA
Battery or USB
IR Input
Vibro
MCU
RGB LED
Back Sns Connector
Light sns
Light Sns Power Control
Programming & debug
Peripheral I2C Pull-Ups
Pill Connector
Pill
Buttons
2 3 12 15
NFC
SPI3, no DMA, 100mA Max curr
<- SVDD is power for MFIN & MFOUT
Radio
Matching circuit
Keep CS High when sleeping
SPI1, no DMA, 25mA Max curr
CC Power Filter
Pins 15, 14, 11, 9, 4, 18
MCO
MCU Power Filter
Pins 11 28 50 73 75 100 22
USB Detect (WKUP2)
OPAMP2 VINP
OPAMP2 VINM
OPAMP2 VOUT
Check if opamp really required
UART
AUDIO
CLK & EN
CHECK IF 1k REQUIRED
Freqs: MCU: 12MHz (48 for USB) Bluetooth: 26MHz NFC: 27.12MHz AudioCodec: 12MHz from MCU Radio: 27MHz
Power MCU: 3v3 Bluetooth: 1v8 NFC: 3v3 Audio: 3v3 + Battery Radio: 3v3
Bluetooth: 4v8 + 1v8, up to 115mA
PullUp when off

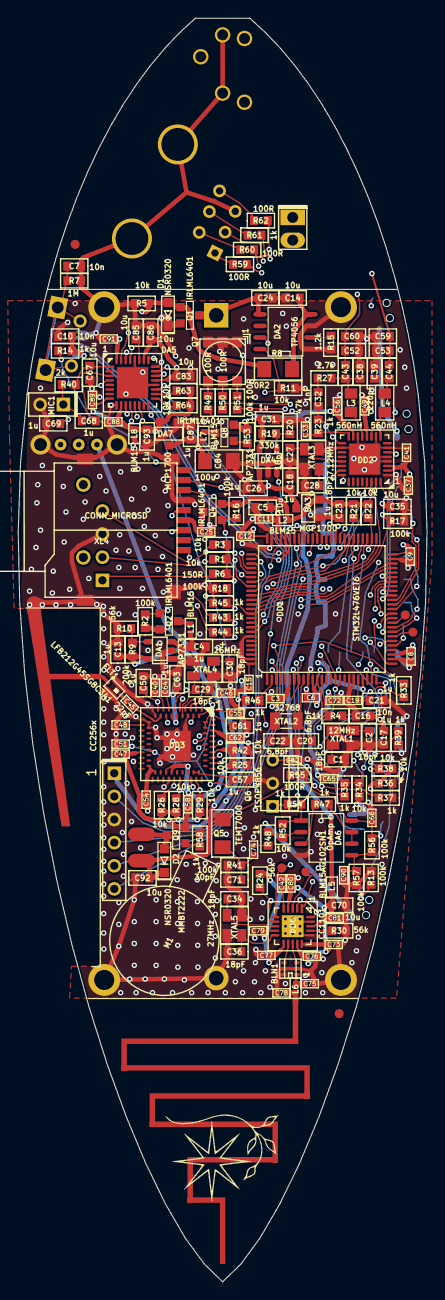
[picture p6: board SndLocket.kicad_pcb from above]

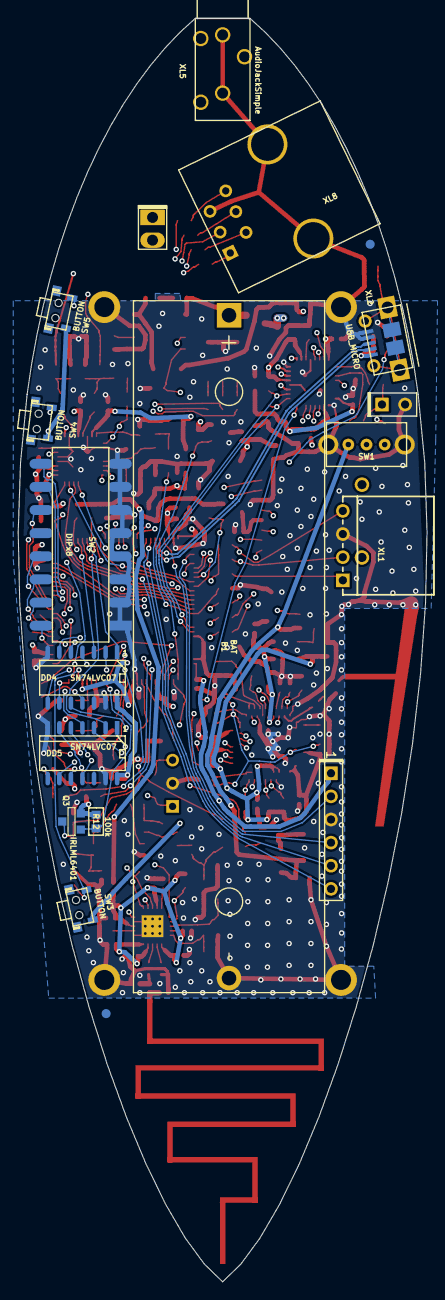
[picture p7: board SndLocket.kicad_pcb from below]

Board: 4 copper layers, 44.9 x 138.8 mm, 226 parts (17 on the bottom side), 173 nets.
