Kreyl/LocketSound/SndLckt L476V.ioc

Mcu.UserName=STM32L476VGTx
PA0.Signal=SYS_WKUP1
PA1.Signal=GPIO_Input
PA10.Signal=USART1_RX
PA11.Signal=USB_OTG_FS_DM
PA12.Signal=USB_OTG_FS_DP
PA2.Signal=RCC_LSCO
PA3.Signal=GPIO_Input
PA6.Signal=OPAMP2_VINP
PA7.Signal=OPAMP2_VINM
PA8.Signal=RCC_MCO
PA9.Signal=USART1_TX
PB0.Signal=OPAMP2_VOUT
PB1.Signal=GPIO_Input
PB10.Signal=I2C2_SCL
PB11.Signal=I2C2_SDA
PB12.Signal=GPIO_Output
PB13.Signal=USART3_CTS
PB14.Signal=USART3_RTS
PB15.Signal=S_TIM15_CH2
PB2.Signal=GPIO_Input
PB6.Signal=I2C1_SCL
PB7.Signal=I2C1_SDA
PC0.Signal=GPIO_Input
PC1.Signal=GPIO_Output
PC10.Signal=SDMMC1_D2
PC11.Signal=SDMMC1_D3
PC12.Signal=SDMMC1_CK
PC13.Signal=SYS_WKUP2
PC2.Signal=GPIO_Output
PC6.Signal=S_TIM3_CH1
PC7.Signal=S_TIM3_CH2
PC8.Signal=SDMMC1_D0
PC9.Signal=SDMMC1_D1
PD0.Signal=GPIO_Output
PD1.Signal=SPI2_SCK
PD10.Signal=GPIO_Output
PD11.Signal=GPIO_Output
PD12.Signal=S_TIM4_CH1
PD13.Signal=S_TIM4_CH2
PD14.Signal=S_TIM4_CH3
PD15.Signal=S_TIM4_CH4
PD2.Signal=SDMMC1_CMD
PD3.Signal=SPI2_MISO
PD4.Signal=SPI2_MOSI
PD5.Signal=GPIO_Input
PD6.Signal=GPIO_Output
PD7.Signal=GPIO_Output
PD8.Signal=USART3_TX
PD9.Signal=USART3_RX
PE12.Signal=GPIO_Output
PE13.Signal=SPI1_SCK
PE14.Signal=SPI1_MISO
PE15.Signal=SPI1_MOSI
PE2.Signal=GPIO_Output
PE3.Signal=SAI1_SD_B
PE4.Signal=SAI1_FS_A
PE5.Signal=SAI1_SCK_A
PE6.Signal=SAI1_SD_A
