Kreyl/LocketSound/SoundLocket_fw/Radio/cc1101.cpp

/*
 * cc1101.cpp
 *
 *  Created on: Feb 12, 2013
 *      Author: g.kruglov
 */

#include "cc1101.h"
#include "uart.h"

#define CC_MAX_BAUDRATE_HZ  6500000

extern cc1101_t CC;

void CCIrqHandler() { CC.IIrqHandler(); }

uint8_t cc1101_t::Init() {
    // ==== GPIO ====
#if defined STM32L1XX || defined STM32F4XX || defined STM32L4XX
    AlterFunc_t CC_AF;
    if(ISpi.PSpi == SPI1 or ISpi.PSpi == SPI2) CC_AF = AF5;
    else CC_AF = AF6;
#elif defined STM32F030 || defined STM32F0
#define CC_AF   AF0
#endif
    PinSetupOut      ((GPIO_TypeDef*)CSGpio, Cs,   omPushPull);
    PinSetupAlterFunc((GPIO_TypeDef*)SpiGpio, Sck,  omPushPull, pudNone, CC_AF);
    PinSetupAlterFunc((GPIO_TypeDef*)SpiGpio, Miso, omPushPull, pudNone, CC_AF);
    PinSetupAlterFunc((GPIO_TypeDef*)SpiGpio, Mosi, omPushPull, pudNone, CC_AF);
    IGdo0.Init(ttFalling);
    CsHi();
    // ==== SPI ====
    // MSB first, master, ClkLowIdle, FirstEdge, Baudrate no more than 6.5MHz
    ISpi.Setup(boMSB, cpolIdleLow, cphaFirstEdge, CC_MAX_BAUDRATE_HZ);
    ISpi.Enable();
    // ==== Init CC ====
    if(Reset() != retvOk) {
        ISpi.Disable();
        Printf("CC Rst Fail\r");
        return retvFail;
    }
    // Check if Write/Read ok
    if(WriteRegister(CC_PKTLEN, 7) != retvOk) {
        Printf("CC W Fail\r");
        return retvFail;
    }
    uint8_t b = 0;
    if(ReadRegister(CC_PKTLEN, &b) == retvOk) {
        if(b != 7) {
            Printf("CC R/W Fail; rpl=%u\r", b);
            return retvFail;
        }
    }
    else {
        Printf("CC R Fail\r");
        return retvFail;
    }
    // Proceed with init
    FlushRxFIFO();
    RfConfig();
    IGdo0.EnableIrq(IRQ_PRIO_HIGH);
    Printf("CC init ok\r");
    return retvOk;
}

#if 1 // ==== Setup CC with needed values ====
void cc1101_t::RfConfig() {
    WriteRegister(CC_FSCTRL1,  CC_FSCTRL1_VALUE);    // Frequency synthesizer control.
    WriteRegister(CC_FSCTRL0,  CC_FSCTRL0_VALUE);    // Frequency synthesizer control.
    WriteRegister(CC_FREQ2,    CC_FREQ2_VALUE);      // Frequency control word, high byte.
    WriteRegister(CC_FREQ1,    CC_FREQ1_VALUE);      // Frequency control word, middle byte.
    WriteRegister(CC_FREQ0,    CC_FREQ0_VALUE);      // Frequency control word, low byte.
    WriteRegister(CC_MDMCFG4,  CC_MDMCFG4_VALUE);    // Modem configuration.
    WriteRegister(CC_MDMCFG3,  CC_MDMCFG3_VALUE);    // Modem configuration.
    WriteRegister(CC_MDMCFG2,  CC_MDMCFG2_VALUE);    // Modem configuration.
    WriteRegister(CC_MDMCFG1,  CC_MDMCFG1_VALUE);    // Modem configuration.
    WriteRegister(CC_MDMCFG0,  CC_MDMCFG0_VALUE);    // Modem configuration.
    WriteRegister(CC_CHANNR,   CC_CHANNR_VALUE);     // Channel number.
    WriteRegister(CC_DEVIATN,  CC_DEVIATN_VALUE);    // Modem deviation setting (when FSK modulation is enabled).
    WriteRegister(CC_FREND1,   CC_FREND1_VALUE);     // Front end RX configuration.
    WriteRegister(CC_FREND0,   CC_FREND0_VALUE);     // Front end RX configuration.
    WriteRegister(CC_MCSM0,    CC_MCSM0_VALUE);      // Main Radio Control State Machine configuration.
    WriteRegister(CC_FOCCFG,   CC_FOCCFG_VALUE);     // Frequency Offset Compensation Configuration.
    WriteRegister(CC_BSCFG,    CC_BSCFG_VALUE);      // Bit synchronization Configuration.
    WriteRegister(CC_AGCCTRL2, CC_AGCCTRL2_VALUE);   // AGC control.
    WriteRegister(CC_AGCCTRL1, CC_AGCCTRL1_VALUE);   // AGC control.
    WriteRegister(CC_AGCCTRL0, CC_AGCCTRL0_VALUE);   // AGC control.
    WriteRegister(CC_FSCAL3,   CC_FSCAL3_VALUE);     // Frequency synthesizer calibration.
    WriteRegister(CC_FSCAL2,   CC_FSCAL2_VALUE);     // Frequency synthesizer calibration.
    WriteRegister(CC_FSCAL1,   CC_FSCAL1_VALUE);     // Frequency synthesizer calibration.
    WriteRegister(CC_FSCAL0,   CC_FSCAL0_VALUE);     // Frequency synthesizer calibration.
    WriteRegister(CC_TEST2,    CC_TEST2_VALUE);      // Various test settings.
    WriteRegister(CC_TEST1,    CC_TEST1_VALUE);      // Various test settings.
    WriteRegister(CC_TEST0,    CC_TEST0_VALUE);      // Various test settings.
    WriteRegister(CC_FIFOTHR,  CC_FIFOTHR_VALUE);    // fifo threshold
    WriteRegister(CC_IOCFG2,   CC_IOCFG2_VALUE);     // GDO2 output pin configuration.
    WriteRegister(CC_IOCFG0,   CC_IOCFG0_VALUE);     // GDO0 output pin configuration.
    WriteRegister(CC_PKTCTRL1, CC_PKTCTRL1_VALUE);   // Packet automation control.
    WriteRegister(CC_PKTCTRL0, CC_PKTCTRL0_VALUE);   // Packet automation control.

    WriteRegister(CC_PATABLE, CC_Pwr0dBm);

    WriteRegister(CC_MCSM2, CC_MCSM2_VALUE);
    WriteRegister(CC_MCSM1, CC_MCSM1_VALUE);
}
#endif

#if 1 // ======================= TX, RX, freq and power ========================
void cc1101_t::PowerOff() {
    while(IState != CC_STB_IDLE) EnterIdle();
    EnterPwrDown();
}

void cc1101_t::SetChannel(uint8_t AChannel) {
    while(IState != CC_STB_IDLE) EnterIdle();   // CC must be in IDLE mode
    WriteRegister(CC_CHANNR, AChannel);         // Now set channel
}

//void cc1101_t::WaitUntilChannelIsBusy() {
//    uint8_t b;
//    for(uint32_t i=0; i<207; i++) {
//        b = ReadRegister(CC_PKTSTATUS);
//        if(b & 0b00010000) break;
//        //Uart.Printf("C");
//    }
//    //Uart.Printf("\r");
//}

void cc1101_t::Transmit(void *Ptr, uint8_t Len) {
//     WaitUntilChannelIsBusy();   // If this is not done, time after time FIFO is destroyed
//    while(IState != CC_STB_IDLE) EnterIdle();
    EnterTX();  // Start transmission of preamble while writing FIFO
    chSysLock();
    WriteTX((uint8_t*)Ptr, Len);
    // Enter TX and wait IRQ
    chThdSuspendS(&ThdRef); // Wait IRQ
    chSysUnlock();          // Will be here when IRQ fires
}

// Enter RX mode and wait reception for Timeout_ms.
uint8_t cc1101_t::Receive(uint32_t Timeout_ms, void *Ptr, uint8_t Len, int8_t *PRssi) {
//    Recalibrate();
    FlushRxFIFO();
    chSysLock();
    EnterRX();
    msg_t Rslt = chThdSuspendTimeoutS(&ThdRef, TIME_MS2I(Timeout_ms));    // Wait IRQ
    chSysUnlock();  // Will be here when IRQ will fire, or timeout occur - with appropriate message

    if(Rslt == MSG_TIMEOUT) {   // Nothing received, timeout occured
        EnterIdle();            // Get out of RX mode
        return retvTimeout;
    }
    else return ReadFIFO(Ptr, PRssi, Len);
    return retvOk;
}

// Return RSSI in dBm
int8_t cc1101_t::RSSI_dBm(uint8_t ARawRSSI) {
    int16_t RSSI = ARawRSSI;
    if (RSSI >= 128) RSSI -= 256;
    RSSI = (RSSI / 2) - 74;    // now it is in dBm
    return RSSI;
}
#endif

#if 1 // ======================== Registers & Strobes ==========================
uint8_t cc1101_t::ReadRegister (uint8_t ARegAddr, uint8_t *PData) {
    CsLo();                     // Start transmission
    if(BusyWait() != retvOk) {  // Wait for chip to become ready
        CsHi();
        return retvFail;
    }
    ISpi.ReadWriteByte(ARegAddr | CC_READ_FLAG);    // Transmit header byte
    *PData = ISpi.ReadWriteByte(0);                 // Read reply
    CsHi();                                         // End transmission
    return retvOk;
}
uint8_t cc1101_t::WriteRegister (uint8_t ARegAddr, uint8_t AData) {
    CsLo();                     // Start transmission
    if(BusyWait() != retvOk) {      // Wait for chip to become ready
        CsHi();
        return retvFail;
    }
    ISpi.ReadWriteByte(ARegAddr);   // Transmit header byte
    ISpi.ReadWriteByte(AData);      // Write data
    CsHi();                         // End transmission
    return retvOk;
}
uint8_t cc1101_t::WriteStrobe (uint8_t AStrobe) {
    CsLo();                     // Start transmission
    if(BusyWait() != retvOk) {  // Wait for chip to become ready
        CsHi();
        return retvFail;
    }
    IState = ISpi.ReadWriteByte(AStrobe);   // Write strobe
    CsHi();                                 // End transmission
    IState &= 0b01110000;                   // Mask needed bits
    return retvOk;
}

uint8_t cc1101_t::WriteTX(uint8_t* Ptr, uint8_t Length) {
    CsLo();                                                     // Start transmission
    if(BusyWait() != retvOk) { // Wait for chip to become ready
        CsHi();
        return retvFail;
    }
    ISpi.ReadWriteByte(CC_FIFO|CC_WRITE_FLAG|CC_BURST_FLAG);    // Address with write & burst flags
//    Printf("TX: ");
    for(uint8_t i=0; i<Length; i++) {
        uint8_t b = *Ptr++;
        ISpi.ReadWriteByte(b);  // Write bytes
//        Printf("%X ", b);
    }
    CsHi();    // End transmission
//    Printf("\r");
    return retvOk;
}

uint8_t cc1101_t::ReadFIFO(void *Ptr, int8_t *PRssi, uint8_t Len) {
    uint8_t b, *p = (uint8_t*)Ptr;
     // Check if received successfully
     if(ReadRegister(CC_PKTSTATUS, &b) != retvOk) return retvFail;
     //    Uart.Printf("St: %X  ", b);
     if(b & 0x80) {  // CRC OK
         // Read FIFO
         CsLo();                // Start transmission
         if(BusyWait() != retvOk) { // Wait for chip to become ready
             CsHi();
             return retvFail;
         }
         ISpi.ReadWriteByte(CC_FIFO|CC_READ_FLAG|CC_BURST_FLAG); // Address with read & burst flags
         for(uint8_t i=0; i<Len; i++) { // Read bytes
             b = ISpi.ReadWriteByte(0);
             *p++ = b;
             // Uart.Printf(" %X", b);
         }
         // Receive two additional info bytes
         b = ISpi.ReadWriteByte(0); // RSSI
         ISpi.ReadWriteByte(0);     // LQI
         CsHi();                    // End transmission
         if(PRssi != nullptr) *PRssi = RSSI_dBm(b);
         return retvOk;
     }
     else return retvFail;
}
#endif
