Kreyl/LocketSound/SoundLocket_fw/os/hal/hal_queues.h

/*
    ChibiOS - Copyright (C) 2006..2018 Giovanni Di Sirio

    Licensed under the Apache License, Version 2.0 (the "License");
    you may not use this file except in compliance with the License.
    You may obtain a copy of the License at

        http://www.apache.org/licenses/LICENSE-2.0

    Unless required by applicable law or agreed to in writing, software
    distributed under the License is distributed on an "AS IS" BASIS,
    WITHOUT WARRANTIES OR CONDITIONS OF ANY KIND, either express or implied.
    See the License for the specific language governing permissions and
    limitations under the License.
*/

/**
 * @file    hal_queues.h
 * @brief   I/O Queues macros and structures.
 *
 * @addtogroup HAL_QUEUES
 * @{
 */

#ifndef HAL_QUEUES_H
#define HAL_QUEUES_H

/*===========================================================================*/
/* Driver constants.                                                         */
/*===========================================================================*/

/**
 * @name    Queue functions returned status value
 * @{
 */
#define Q_OK            MSG_OK      /**< @brief Operation successful.       */
#define Q_TIMEOUT       MSG_TIMEOUT /**< @brief Timeout condition.          */
#define Q_RESET         MSG_RESET   /**< @brief Queue has been reset.       */
#define Q_EMPTY         MSG_TIMEOUT /**< @brief Queue empty.                */
#define Q_FULL          MSG_TIMEOUT /**< @brief Queue full,                 */
/** @} */

/*===========================================================================*/
/* Driver pre-compile time settings.                                         */
/*===========================================================================*/

/*===========================================================================*/
/* Derived constants and error checks.                                       */
/*===========================================================================*/

/*===========================================================================*/
/* Driver data structures and types.                                         */
/*===========================================================================*/

/**
 * @brief   Type of a generic I/O queue structure.
 */
typedef struct io_queue io_queue_t;

/**
 * @brief   Queue notification callback type.
 *
 * @param[in] qp        the queue pointer
 */
typedef void (*qnotify_t)(io_queue_t *qp);

/**
 * @brief   Generic I/O queue structure.
 * @details This structure represents a generic Input or Output asymmetrical
 *          queue. The queue is asymmetrical because one end is meant to be
 *          accessed from a thread context, and thus can be blocking, the other
 *          end is accessible from interrupt handlers or from within a kernel
 *          lock zone and is non-blocking.
 */
struct io_queue {
  threads_queue_t       q_waiting;  /**< @brief Queue of waiting threads.   */
  volatile size_t       q_counter;  /**< @brief Resources counter.          */
  uint8_t               *q_buffer;  /**< @brief Pointer to the queue buffer.*/
  uint8_t               *q_top;     /**< @brief Pointer to the first
                                         location after the buffer.         */
  uint8_t               *q_wrptr;   /**< @brief Write pointer.              */
  uint8_t               *q_rdptr;   /**< @brief Read pointer.               */
  qnotify_t             q_notify;   /**< @brief Data notification callback. */
  void                  *q_link;    /**< @brief Application defined field.  */
};

/**
 * @extends io_queue_t
 *
 * @brief   Type of an input queue structure.
 * @details This structure represents a generic asymmetrical input queue.
 *          Writing to the queue is non-blocking and can be performed from
 *          interrupt handlers or from within a kernel lock zone.
 *          Reading the queue can be a blocking operation and is supposed to
 *          be performed by a system thread.
 */
typedef io_queue_t input_queue_t;

/**
 * @extends io_queue_t
 *
 * @brief   Type of an output queue structure.
 * @details This structure represents a generic asymmetrical output queue.
 *          Reading from the queue is non-blocking and can be performed from
 *          interrupt handlers or from within a kernel lock zone.
 *          Writing the queue can be a blocking operation and is supposed to
 *          be performed by a system thread.
 */
typedef io_queue_t output_queue_t;

/*===========================================================================*/
/* Driver macros.                                                            */
/*===========================================================================*/

/**
 * @name    Macro Functions
 * @{
 */
/**
 * @brief   Returns the queue's buffer size.
 *
 * @param[in] qp        pointer to a @p io_queue_t structure
 * @return              The buffer size.
 *
 * @xclass
 */
#define qSizeX(qp)                                                          \
  /*lint -save -e9033 [10.8] The cast is safe.*/                            \
  ((size_t)((qp)->q_top - (qp)->q_buffer))                                  \
  /*lint -restore*/
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
