Kreyl/LocketSound/(commit log)

2019-02-04 Proceeding w sch
    [SndLocket.kicad_pcb, SndLocket.sch]
2019-02-08 Sound routing done
    [SndLocket.sch]
2019-02-13 + pcb shape
    [SndLocket.kicad_pcb]
2019-02-23 Sent to factory
    [SndLocket.csv, SndLocket.kicad_pcb, SndLocket.sch]
2019-03-19 Proceeding w os adaptation
    [SndLocket.kicad_pcb, SndLocket.sch]
2019-04-01 IR RX in progress
    [SndLocket.kicad_pcb]
